DariusV21/VILKAS/mechanical/README.md

# Mechanical files

| Folder | Contents |
|---|---|
| [`VILKAS-RX/`](VILKAS-RX/) | STEP model of the receiver board (Rev C). There's no Rev D model yet because there's no hardware. |
| [`VILKAS-TX/`](VILKAS-TX/) | STEP models of the remote PCB with components (Rev B and Rev C) |
| [`enclosure/`](enclosure/) | Printable STL files of the remote enclosure |

| Board | Outline | Thickness |
|---|---|---|
| VILKAS-RX | 20.0 × 30.0 mm | 1.6 mm PCB. Max component height TBD |
| VILKAS-TX | 75.0 × 95.0 mm (Rev C) | 1.6 mm PCB |

Mounting-hole positions: TBD (add a dimensioned drawing, PDF/PNG).

STEP models show the board outline and component bodies for fitting the boards into robots and enclosures. They aren't manufacturing files.

License: CC BY 4.0.
