DariusV21/VILKAS/mechanical/enclosure/README.md

# VILKAS-TX enclosure (STL)

Add the printable STL files here, e.g.

| File | Part | Suggested print settings |
|---|---|---|
| `VILKAS-TX_top.stl` | Top shell | PLA/PETG, 0.2 mm, 3 walls |
| `VILKAS-TX_bottom.stl` | Bottom shell | |
| `VILKAS-TX_wheel.stl` | Weapon wheel cap | |

Hardware needed (screws, inserts): TBD.

The STL files are open (CC BY 4.0). The source CAD files are not published.
